davidbannon/SolarHotWater/Images/hotwaterctrl_v4.pdf

Hot water controller.

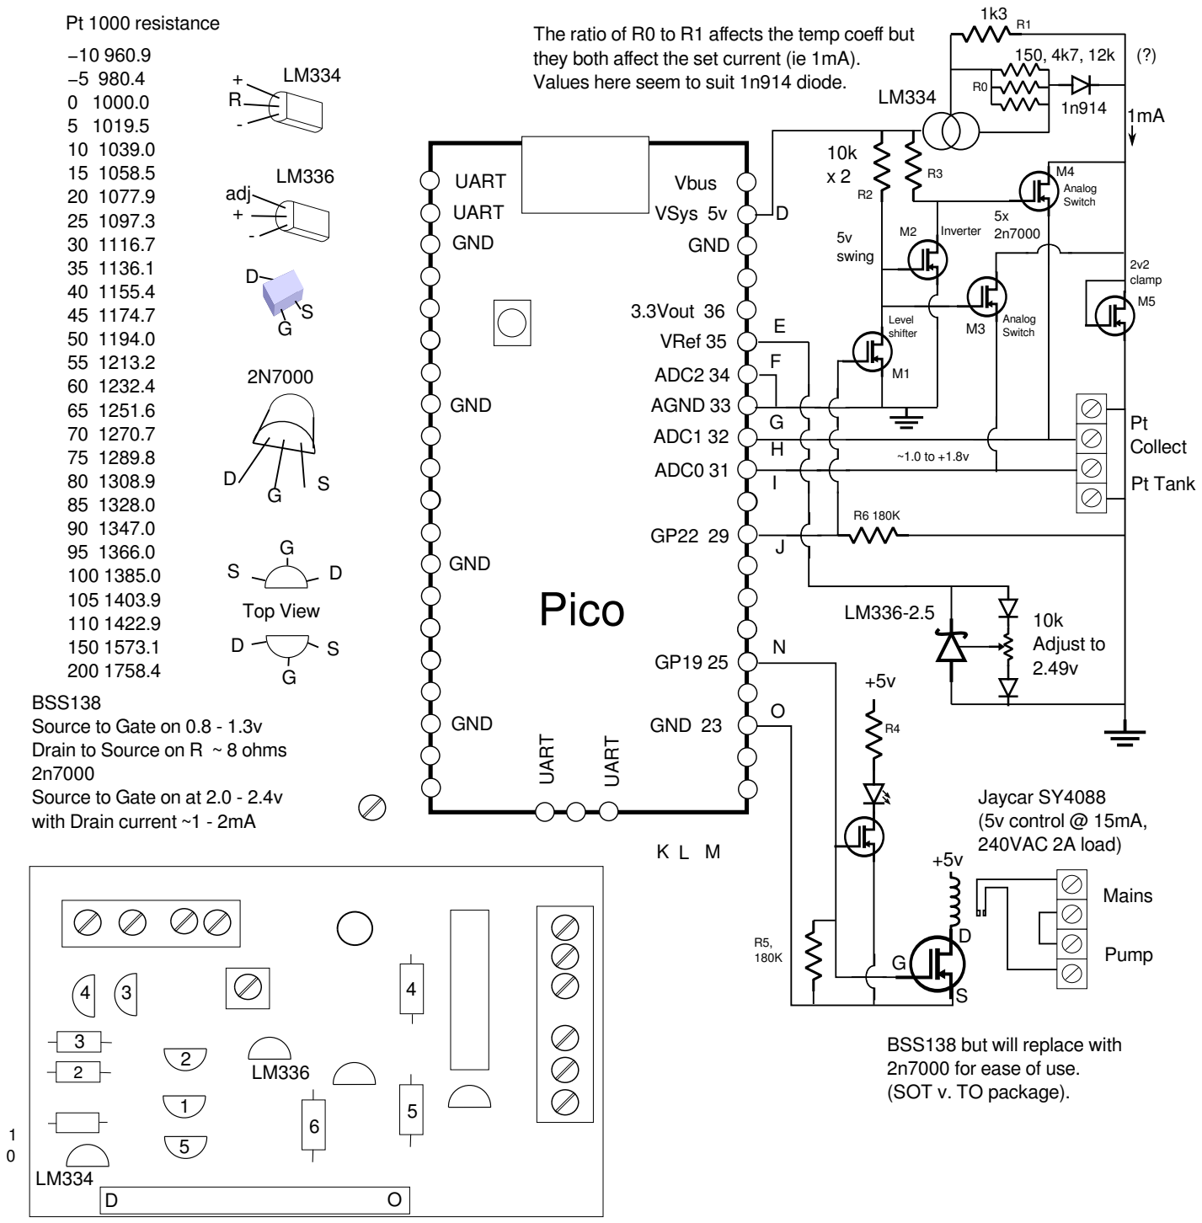
[picture p1: figure]
GND; VRef 35; ADC2 34 AGND 33 ADC1 32; ADC0 31; UART UART; UART; 3.3Vout 36; GND 23; Vbus; Pt 1000 resistance; Pt Collect; Pt Tank; 10k Adjust to 2.49v; Mains; Pump; Pico; BSS138 but will replace with 2n7000 for ease of use. (SOT v. TO package).; Jaycar SY4088 (5v control @ 15mA, 240VAC 2A load); adj +; VSys 5v; BSS138 Source to Gate on 0.8 - 1.3v Drain to Source on R ~ 8 ohms 2n7000 Source to Gate on at 2.0 - 2.4v with Drain current ~1 - 2mA; 5v swing; 2v2 clamp; Analog Switch; Inverter; Level shifter; Values here seem to suit 1n914 diode.; Top View

# Hot Water Controller Mk 4

# David Bannon 2024-08-24

TenthsDegrees := (adc_read() - 1645) * 1000 div 633

We are pulling VRef(ADC) down to 2.5v, this is more that the 3.0v mentioned in Pico docs, a few extra mA through R7, 200Ω rated at 100mW. Should be OK.

The Gnd symbol refers to Analog Ground not digital.

The 2n7000 with gate to drain is a 2v2 clamp, negligable leakage of 2.6uA at 1.7v (compared with 32uA from a string of forward biased diodes). At 2v, ie 200 degrees its still only about 20uA

The ratio of R0 to R1 affects the temp coeff but they both affect the set current (ie 1mA).
