davidbannon/SolarHotWater/Images/2024-07-05.png

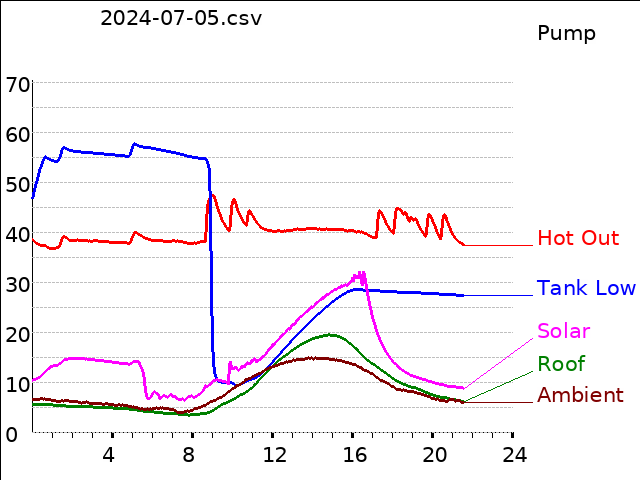
Images/2024-07-05.png
