davidbannon/SolarHotWater/Images/logger.pdf

1
3

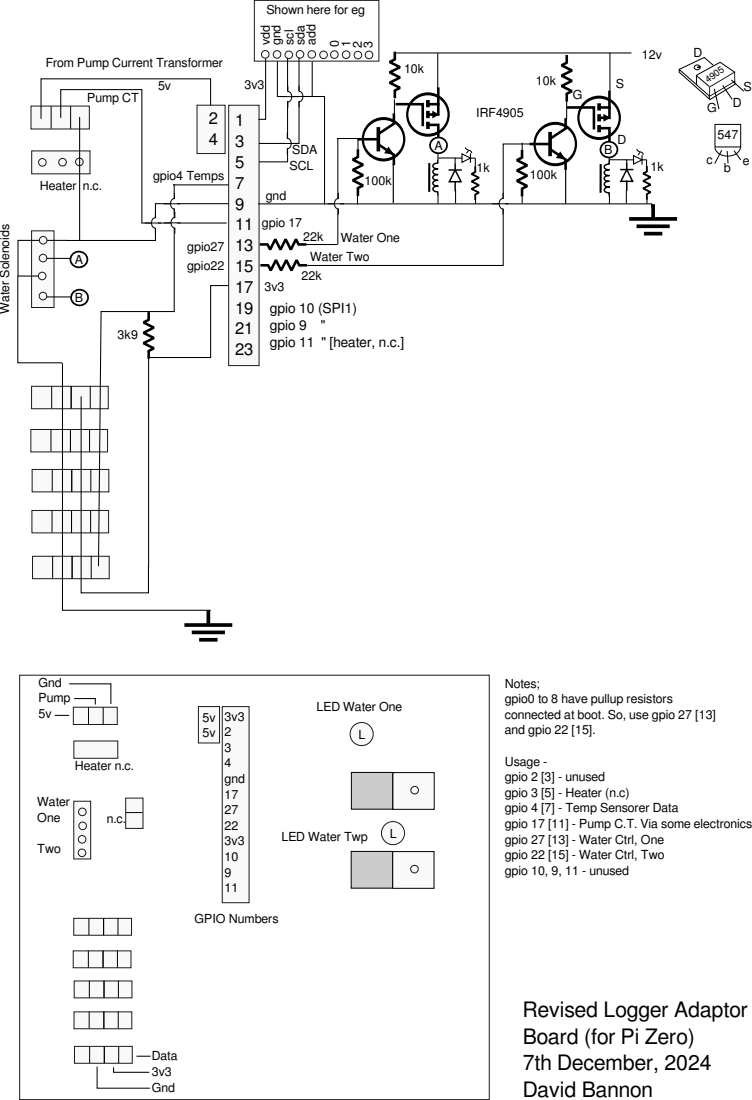
[picture p3: page 1]
IRF4905; Water Solenoids; Pump CT; gpio4 Temps; Heater; 3v3 2 3 4 gnd 17 27 22 3v3 10 9 11; Data 3v3 Gnd; Gnd Pump 5v; Water One; Two; Heater n.c.; GPIO Numbers; Water One Water Two; SDA SCL; sda; add; gpio 10 (SPI1) gpio 9 " gpio 11 " [heater, n.c.]; gpio 17; gpio27 gpio22

Shown here for eg
gnd vdd gnd scl

From Pump Current Transformer

Notes;
gpio0 to 8 have pullup resistors
connected at boot. So, use gpio 27 [13]
and gpio 22 [15].

LED Water One

Usage -
gpio 2 [3] - unused
gpio 3 [5] - Heater (n.c)
gpio 4 [7] - Temp Sensorer Data
gpio 17 [11] - Pump C.T. Via some electronics
gpio 27 [13] - Water Ctrl, One
gpio 22 [15] - Water Ctrl, Two
gpio 10, 9, 11 - unused

LED Water Twp

Revised Logger Adaptor
Board (for Pi Zero)
7th December, 2024
David Bannon
