davidbannon/SolarHotWater/(commit log)

2024-07-08 raspicapture has its own socket svr
2024-09-16 clean up all debug statments (except when something goes wrong)
    [tcp-client.c]
2024-12-07 Allow for new gpio naming model, add app FPC pump ctrl, FPC web server
2024-12-07 bug fix (reporting PumpWasOn) to Pico code, docs
    [tcp-client.c]
2024-12-08 New model for plotting Pump, percent based, direct from PumpCTRL data
2025-02-03 extensive badly doced changes to Pascal Pump CTRL
2026-02-11 Use the esp32 as hwctrl, it runs webservice rather than isock model tha had circular dependencies after a power failure
    [tcp-client.c]
2026-02-11 Added ESP32 code to replace the Pico to control circulation pump
    [hwctrl.ino, webs.cpp, webs.h]
